troymessina/TailFlick/README.md

# TailFlick
Code and schematics for building a tailflick analgesic meter.
See http://www.funjournal.org/wp-content/uploads/2015/09/otto_10_1_a80-a84.pdf?x91298
