troymessina/TailFlick/tail_flick_electrical_diagrams.pdf

# Collector

t12

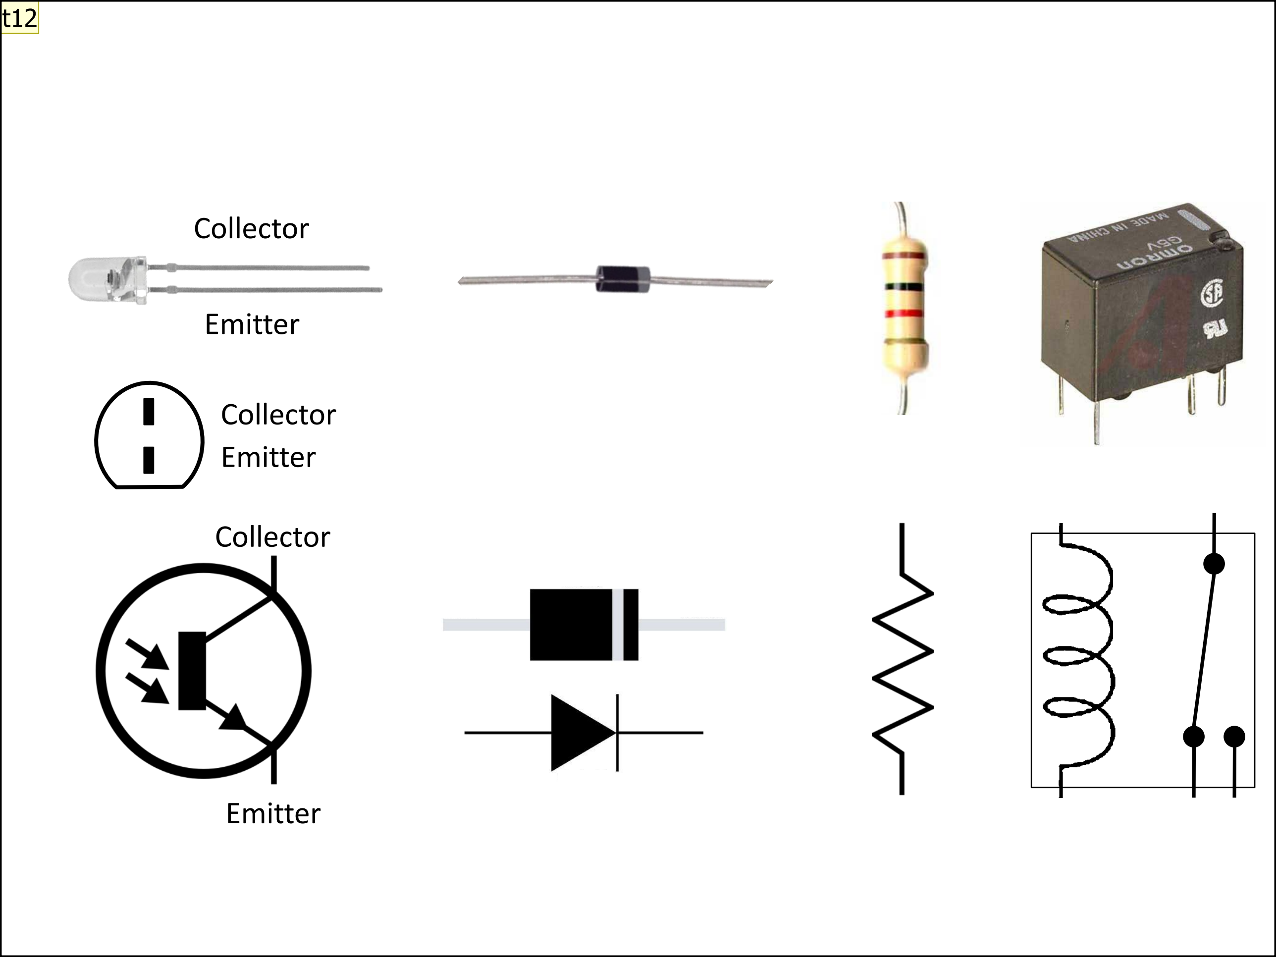
[picture p1: page 1]

# Emitter

# Collector Emitter

# Collector

# Emitter

Slide 1

t12 | Circuit components, photos and circuit diagram equivalents tmessina, 8/23/2011

# Diode

# Base

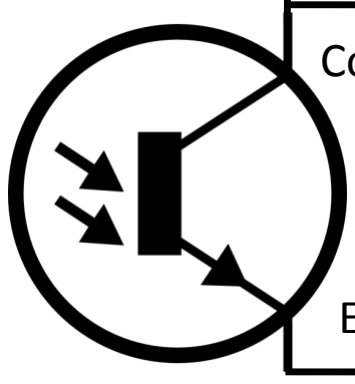
[picture p2: figure]

# Emitter

# Collector

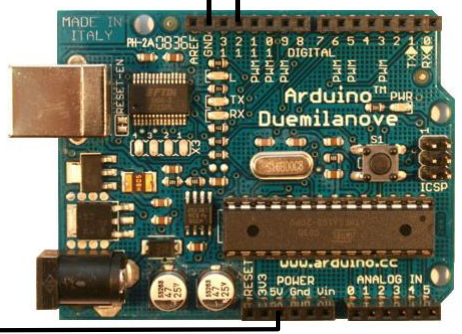
[picture p3: figure]

# USB to computer

# Resistor = 1000 Ω

Slide 2

t11 | Photosensing circuit shown with Arduino duemilanove tmessina, 8/23/2011

# Diode

# Base

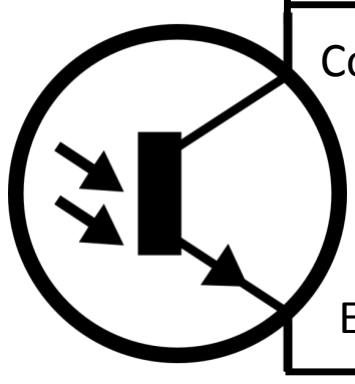
[picture p4: figure]

# Emitter

# Collector

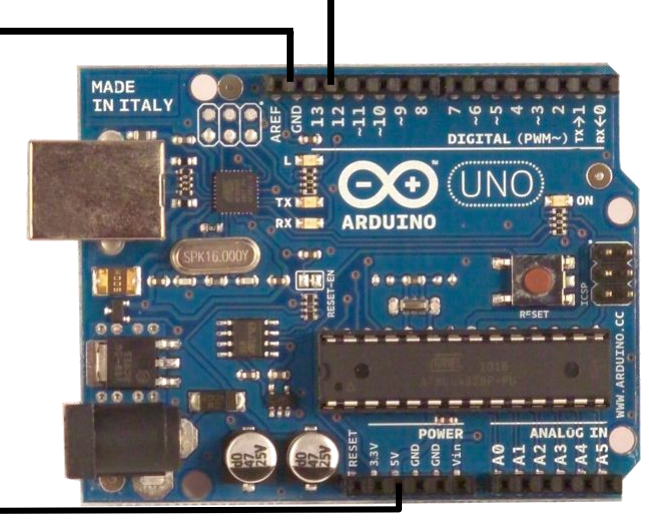
[picture p5: figure]

# USB to computer

# Resistor = 1000 Ω

Slide 3

t10 | Photosensing circuit shown with Arduino Uno tmessina, 8/23/2011

# Diode

# Base

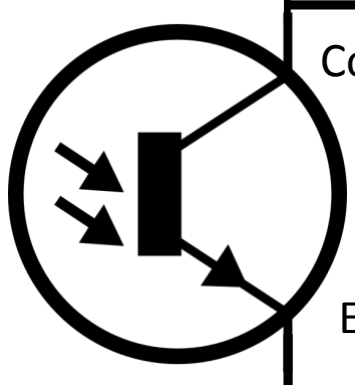
[picture p6: figure]

# Emitter

# Collector

# Resistor = 1000 Ω

# Pin 12

# Ground

# 5 Volts t9

Slide 4

t9 | Photosensing circuit tmessina, 8/23/2011

# 110V from Wall

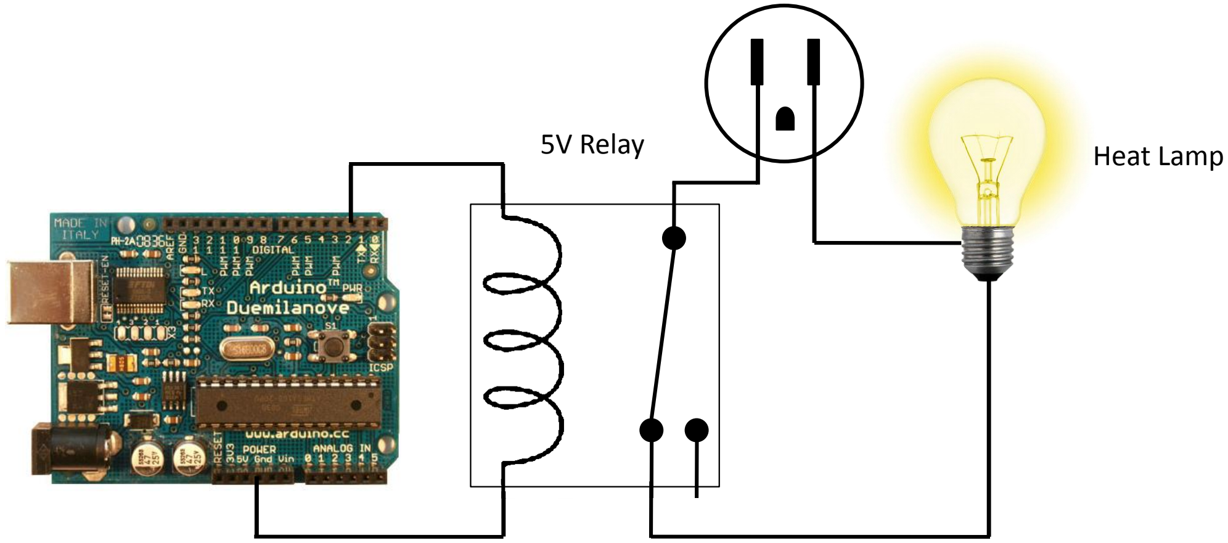
[picture p7: figure]
Heat Lamp 5V Relay

Slide 5

t8 | Heat lamp operating circuit shown with Arduino duemilanove tmessina, 8/23/2011

# 110V from Wall

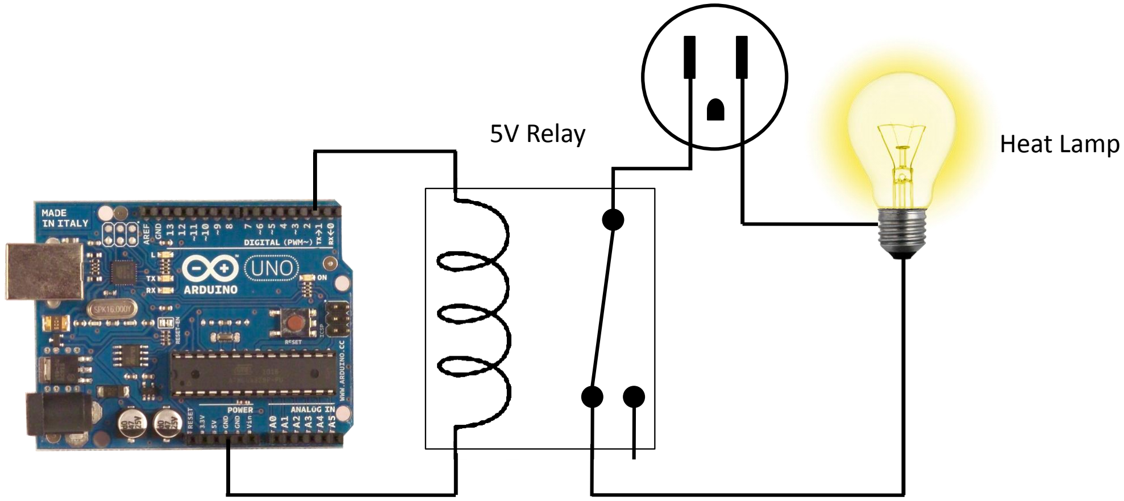
[picture p8: figure]
Heat Lamp 5V Relay

Slide 6

t7 | Heat lamp operating circuit shown with Arduino Uno tmessina, 8/23/2011

# 110 Volts from Wall

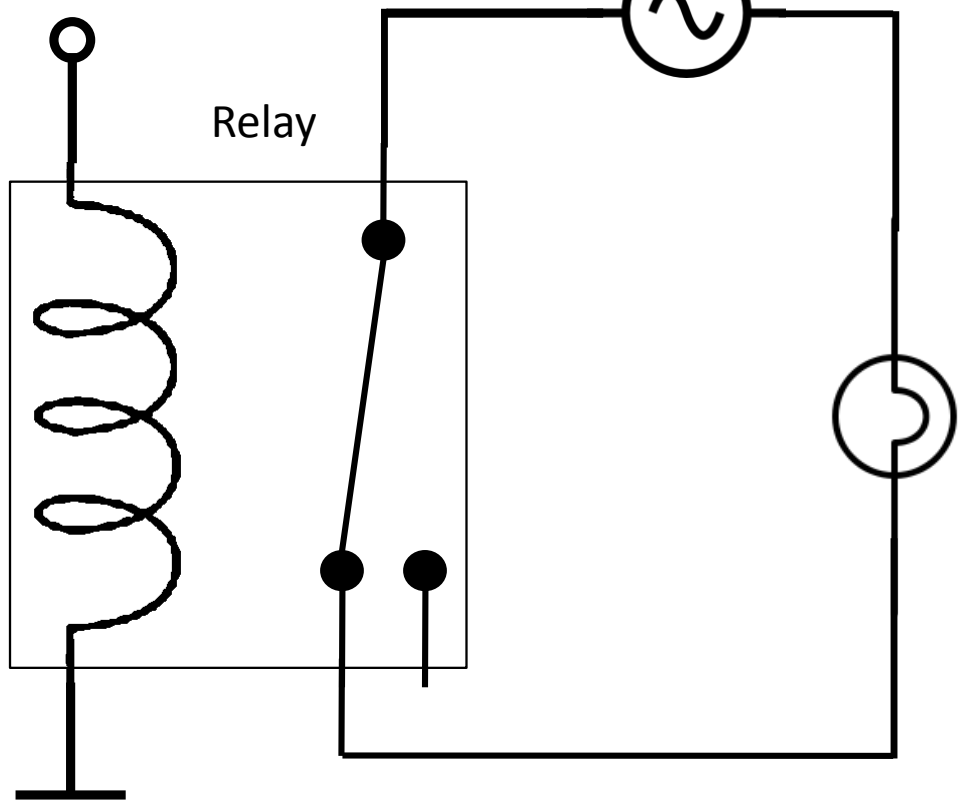
[picture p9: figure]
Relay

# Heat Lamp

# Pin 2

# Ground

Slide 7

t6 | Heat lamp operating circuit tmessina, 8/23/2011

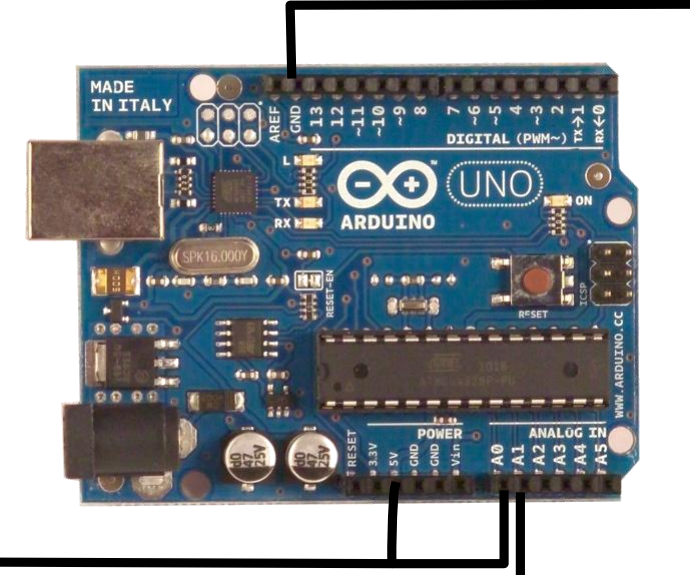
[picture p10: figure]

# USB to computer

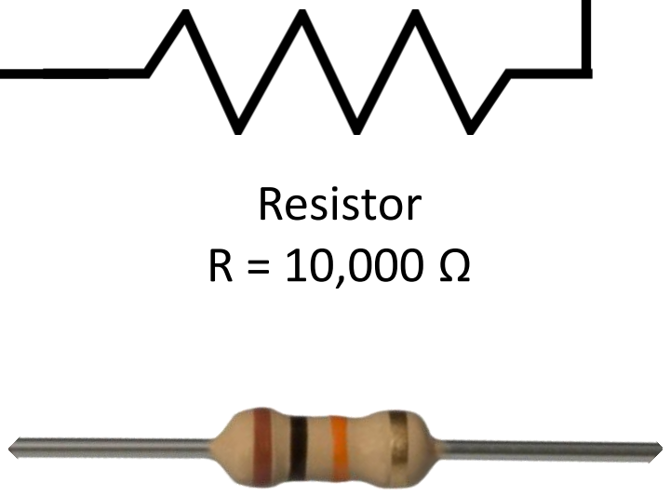
[picture p11: figure]
Resistor R = 10,000 Ω

# Thermistor R(25oC) = 10,000 Ω

Slide 8

t5 | Thermistor circuit for monitoring a single temperature shown with Arduino duemilanove. To measure a second temperature set up the same circuit using A2 instead of A1, do not make a second connection to A0. tmessina, 8/23/2011

# 5 Volts

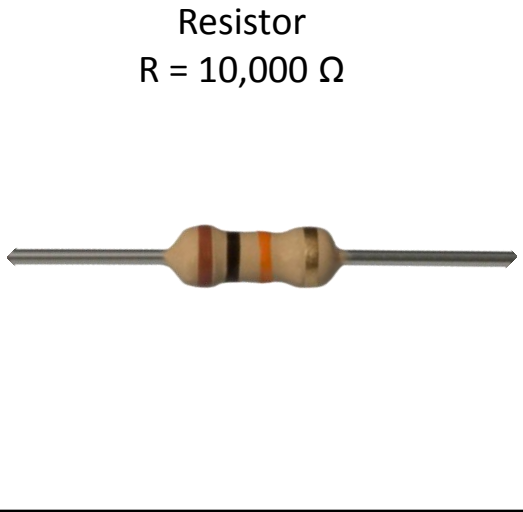
[picture p12: figure]
Resistor R = 10,000 Ω

# Thermistor R(25oC) = 10,000 Ω

Pin A0 | Pin A1 (A2 for second thermistor)

Slide 9

t4 | Thermistor circuit for monitoring a single temperature. To measure a second temperature set up the same circuit using A2 instead of A1, do not make a second connection to A0. tmessina, 8/23/2011

(

d

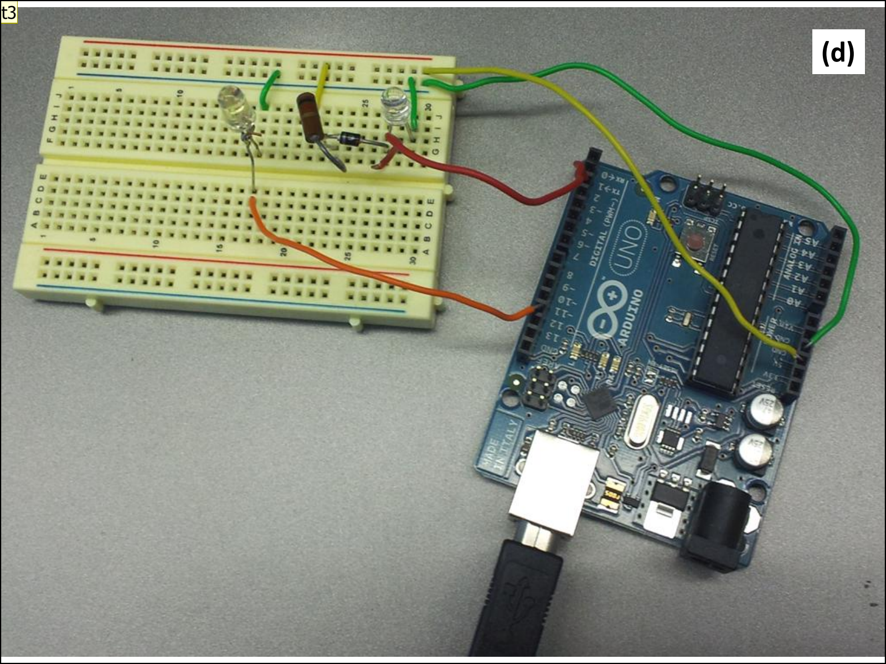
[picture p13: page 19]

)

Slide 10

t3 | Photo of the photosensing and heat lamp operating circuit. An LED is in place of the relay. tmessina, 8/23/2011

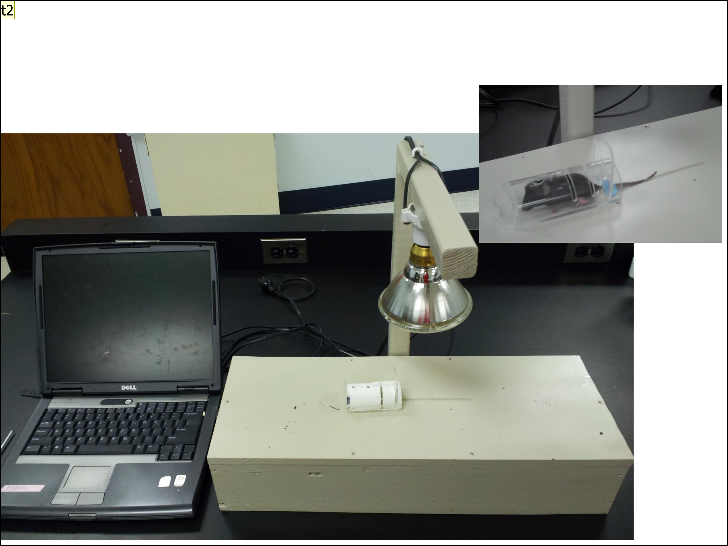
[picture p14: page 21]

Slide 11

t2 | A photo of the entire apparatus and a mouse in a rodent immobilizer. tmessina, 8/23/2011

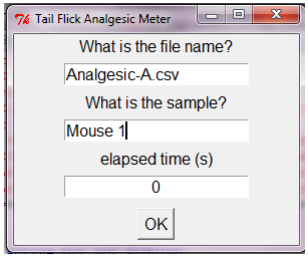
[picture p15: figure]

Slide 12

t1 | The GUI interface created by Python program tmessina, 8/23/2011
