troymessina/TailFlick/(list of files, drawings)

Other design files:
photosense.fz
